Huzaifa-Rahim-Malik/Mini_Swarm_vehicle/images/Swarm_Vehicle.jpg

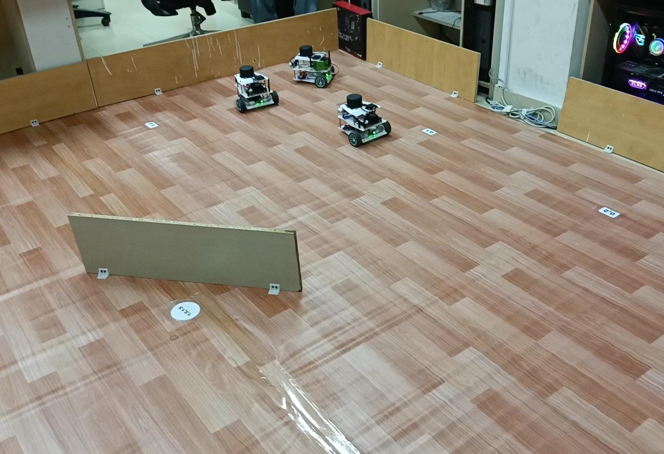
images/Swarm_Vehicle.jpg
