Huzaifa-Rahim-Malik/Mini_Swarm_vehicle/docs/Robotic_Car_BOM.xlsx

Swarm Vehicle BOM |  |  |  | Mechnical 3D printing Material:CPE
Electrical Components
S# | Description | Part Number | Quantity | S# | Description | Dimensions (L x W) | Plate Thickness | Quantity
1 | Metal Ball Caster Wheel 20mm Metal Ball For Robotic Car | - | 1 | 1 | Bottom Plate | 212 x 150 mm | 3mm | 1
2 | 65mm Robot Smart Car Rubber Tire Wheel For Arduino Robot Rover | - | 2 | 2 | Centre Plate | 212 x 150 mm
3 | JGA25-371 Gear Motor with Encoder DC 12V 280RPM | NFP-JGA25-370-EN | 2 | 3 | Top Plate | 150 x 150 mm
4 | L298N H-Bridge Motor Driver Module | L298N | 1 | 4 | Battery Holder | 99 x 64mm
5 | Arduino Nano V3 Pre-Soldered Pins with USB Cable | - | 1
6 | MPU6050 GY-521 6DOF 3 Axis Analog Gyro Sensor + 3 Axis Accelerometer Module | MPU6050 | 1
7 | HW-468 DC-DC step-down module 24v/12V to 5V/5A power supply 9-35V | HW-468 | 1
9 | Brass Standoffs 35mm | - | 8
10 | Brass Standoffs 10mm | - | 20
11 | Misc (Jumper Wires, Zip ties etc) | - | 1
12 | M2x10mm screw,nut,washer | - | 30
13 | M3x10mm screw,nut,washer | - | 30
14 | M4x10mm screw,nut,washer | - | 30
15 | Jetson Nano Development / Expansion Kit (Fan +WIFI module+Heatsink+Charger+SD Card) Raspberry Pi 5 (If use Pi then add Buck Convertor for its power supply) | - | 1
18 | Hiwonder AI Tool for VEX AI Robotics Competition (VAIRC) with Precision Depth Camera & LiDAR for Robot Programming | - | 1
