Huzaifa-Rahim-Malik/Mini_Swarm_vehicle/docs/Schematic.pdf

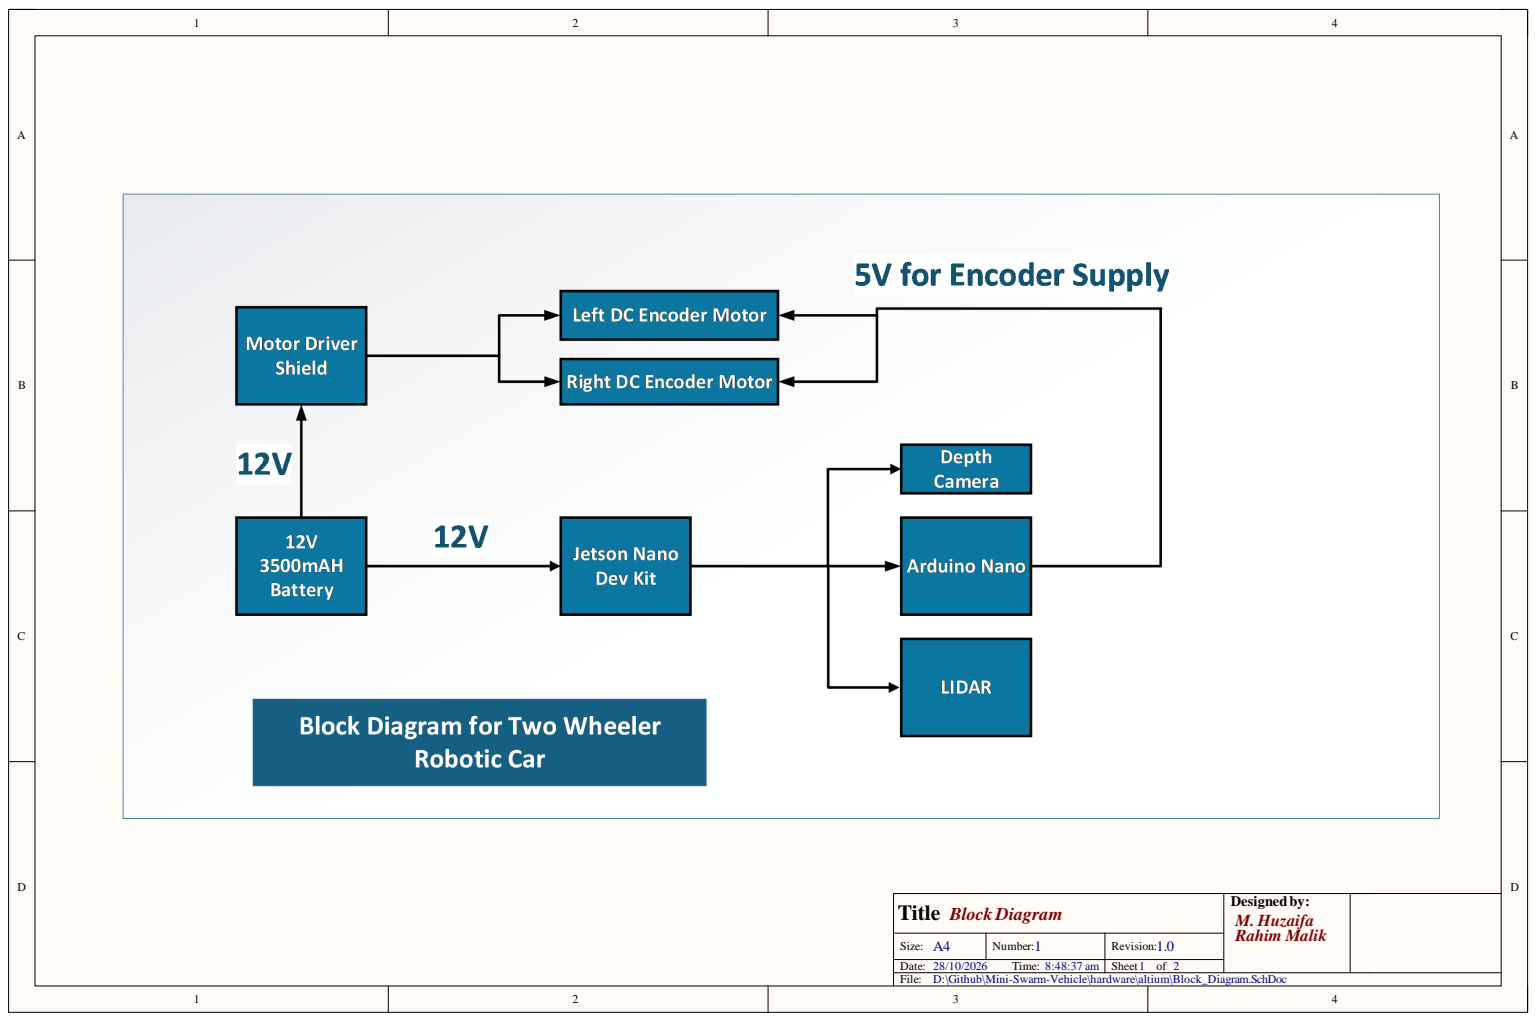
[picture p37: page 1]

D:\Github\Mini-Swarm-Vehicle\hardware\altium\Block_Diagram.SchDoc

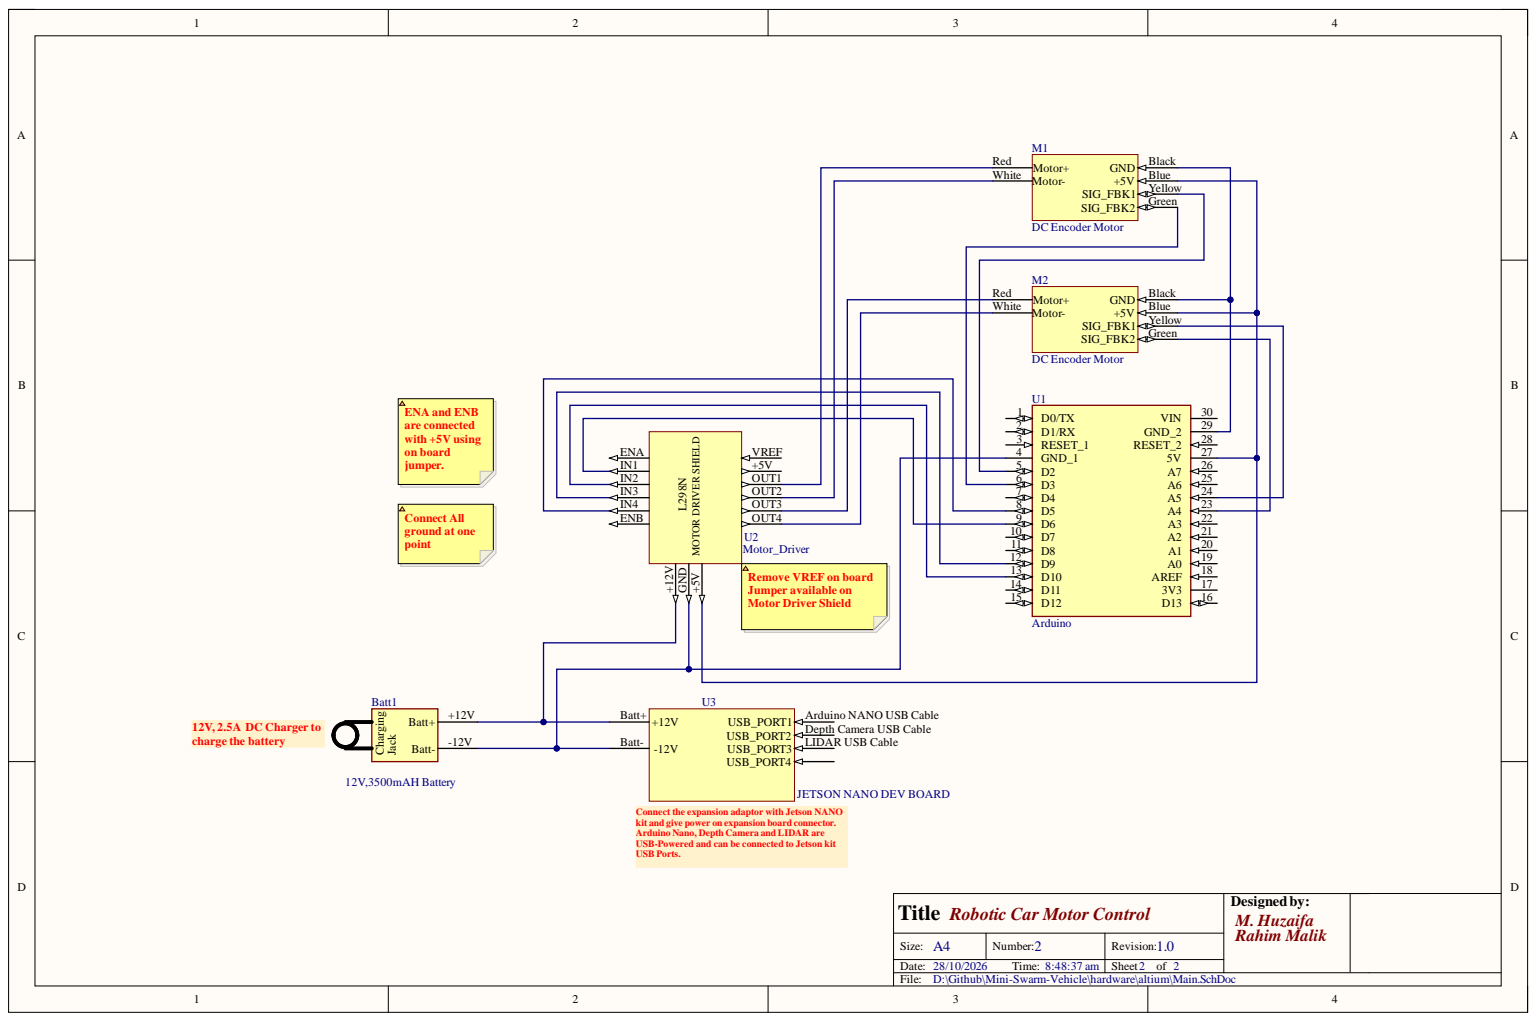
[picture p38: page 2]

D0/TX 1 RESET_2 5V

RESET_1 3 | 28 27

OUT4 | D6 9
Jumper available on Motor Driver Shield | D7 10

Remove VREF on board

JETSON NANO DEV BOARD

Connect the expansion adaptor with Jetson NANO
kit and give power on expansion board connector.
Arduino Nano, Depth Camera and LIDAR are
USB-Powered and can be connected to Jetson kit
USB Ports.

Robotic Car Motor Control

D:\Github\Mini-Swarm-Vehicle\hardware\altium\Main.SchDoc
