Huzaifa-Rahim-Malik/Mini_Swarm_vehicle/docs/Chassis_Plates.pdf

E E

F F

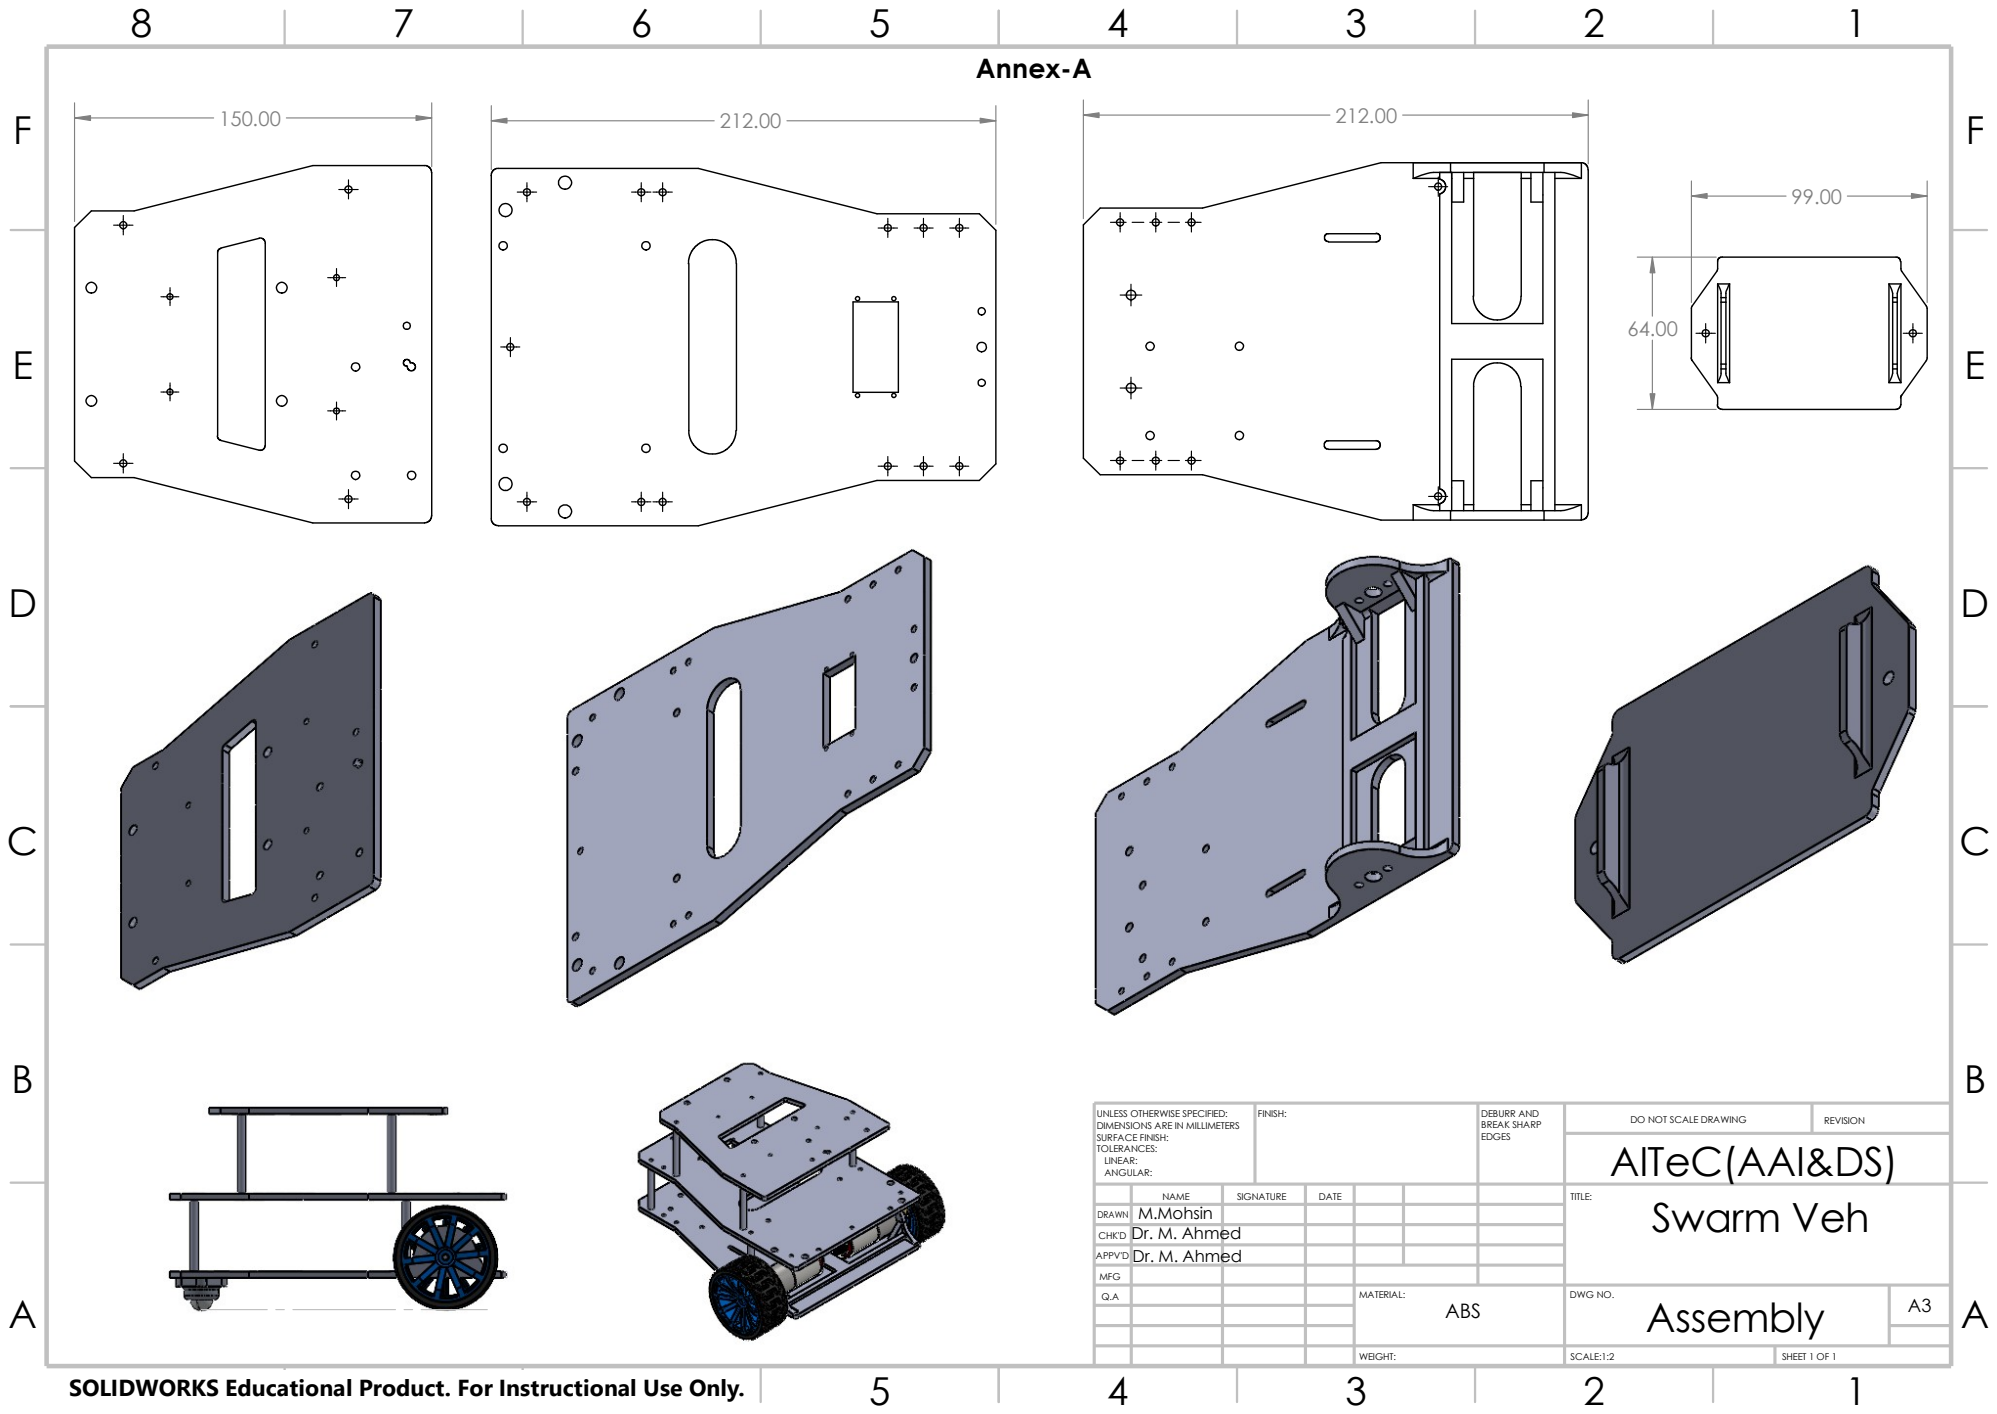
[picture p39: page 1]
WEIGHT:; FINISH:; DO NOT SCALE DRAWING; REVISION; SCALE:1:2; SHEET 1 OF 1; Annex-A

UNLESS OTHERWISE SPECIFIED:
DIMENSIONS ARE IN MILLIMETERS
SURFACE FINISH:
TOLERANCES:
LINEAR:
ANGULAR:

DEBURR AND
BREAK SHARP
EDGES
AITeC(AAI&DS)

DRAWN | M.Mohsin
CHK'D | Dr. M. Ahmed
APPV'D | Dr. M. Ahmed
Q.A | | | | MATERIAL: ABS | DWG NO. Assembly | A3

NAME | SIGNATURE | DATE | | | | TITLE: Swarm Veh

MFG

SOLIDWORKS Educational Product. For Instructional Use Only.
