Huzaifa-Rahim-Malik/Mini_Swarm_vehicle/(list of files, drawings)

Other design files:
hardware/altium/Block_Diagram.SchDoc
hardware/altium/Main.SchDoc
hardware/altium/Schlib1.SchLib
hardware/altium/Two_Wheeler.PrjPcb
