Huzaifa-Rahim-Malik/Mini_Swarm_vehicle/(commit log)

2026-10-07 Initial commit: Mini Swarm Vehicle (mechanical design, Altium electronics, Arduino firmware, docs)
    [Block_Diagram.SchDoc, Main.SchDoc, Schlib1.SchLib, Two_Wheeler.PrjPcb]
2026-10-07 Initial commit with new data
    [Robotic_Car_BOM.xlsx]
2026-10-07 Update files
    [Robotic_Car_Hardware_Wiring.xlsx]
